hps-mershov/clock_design/clock_design.jpg

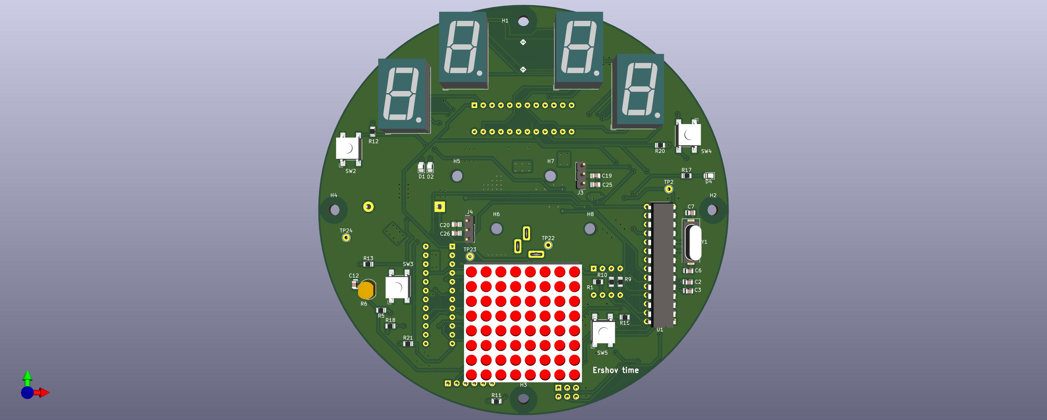
clock_design.jpg
