hps-mershov/clock_design/clock_design.kicad_pcb

## KiCad design clock_design.kicad_pcb (2022-07-19)

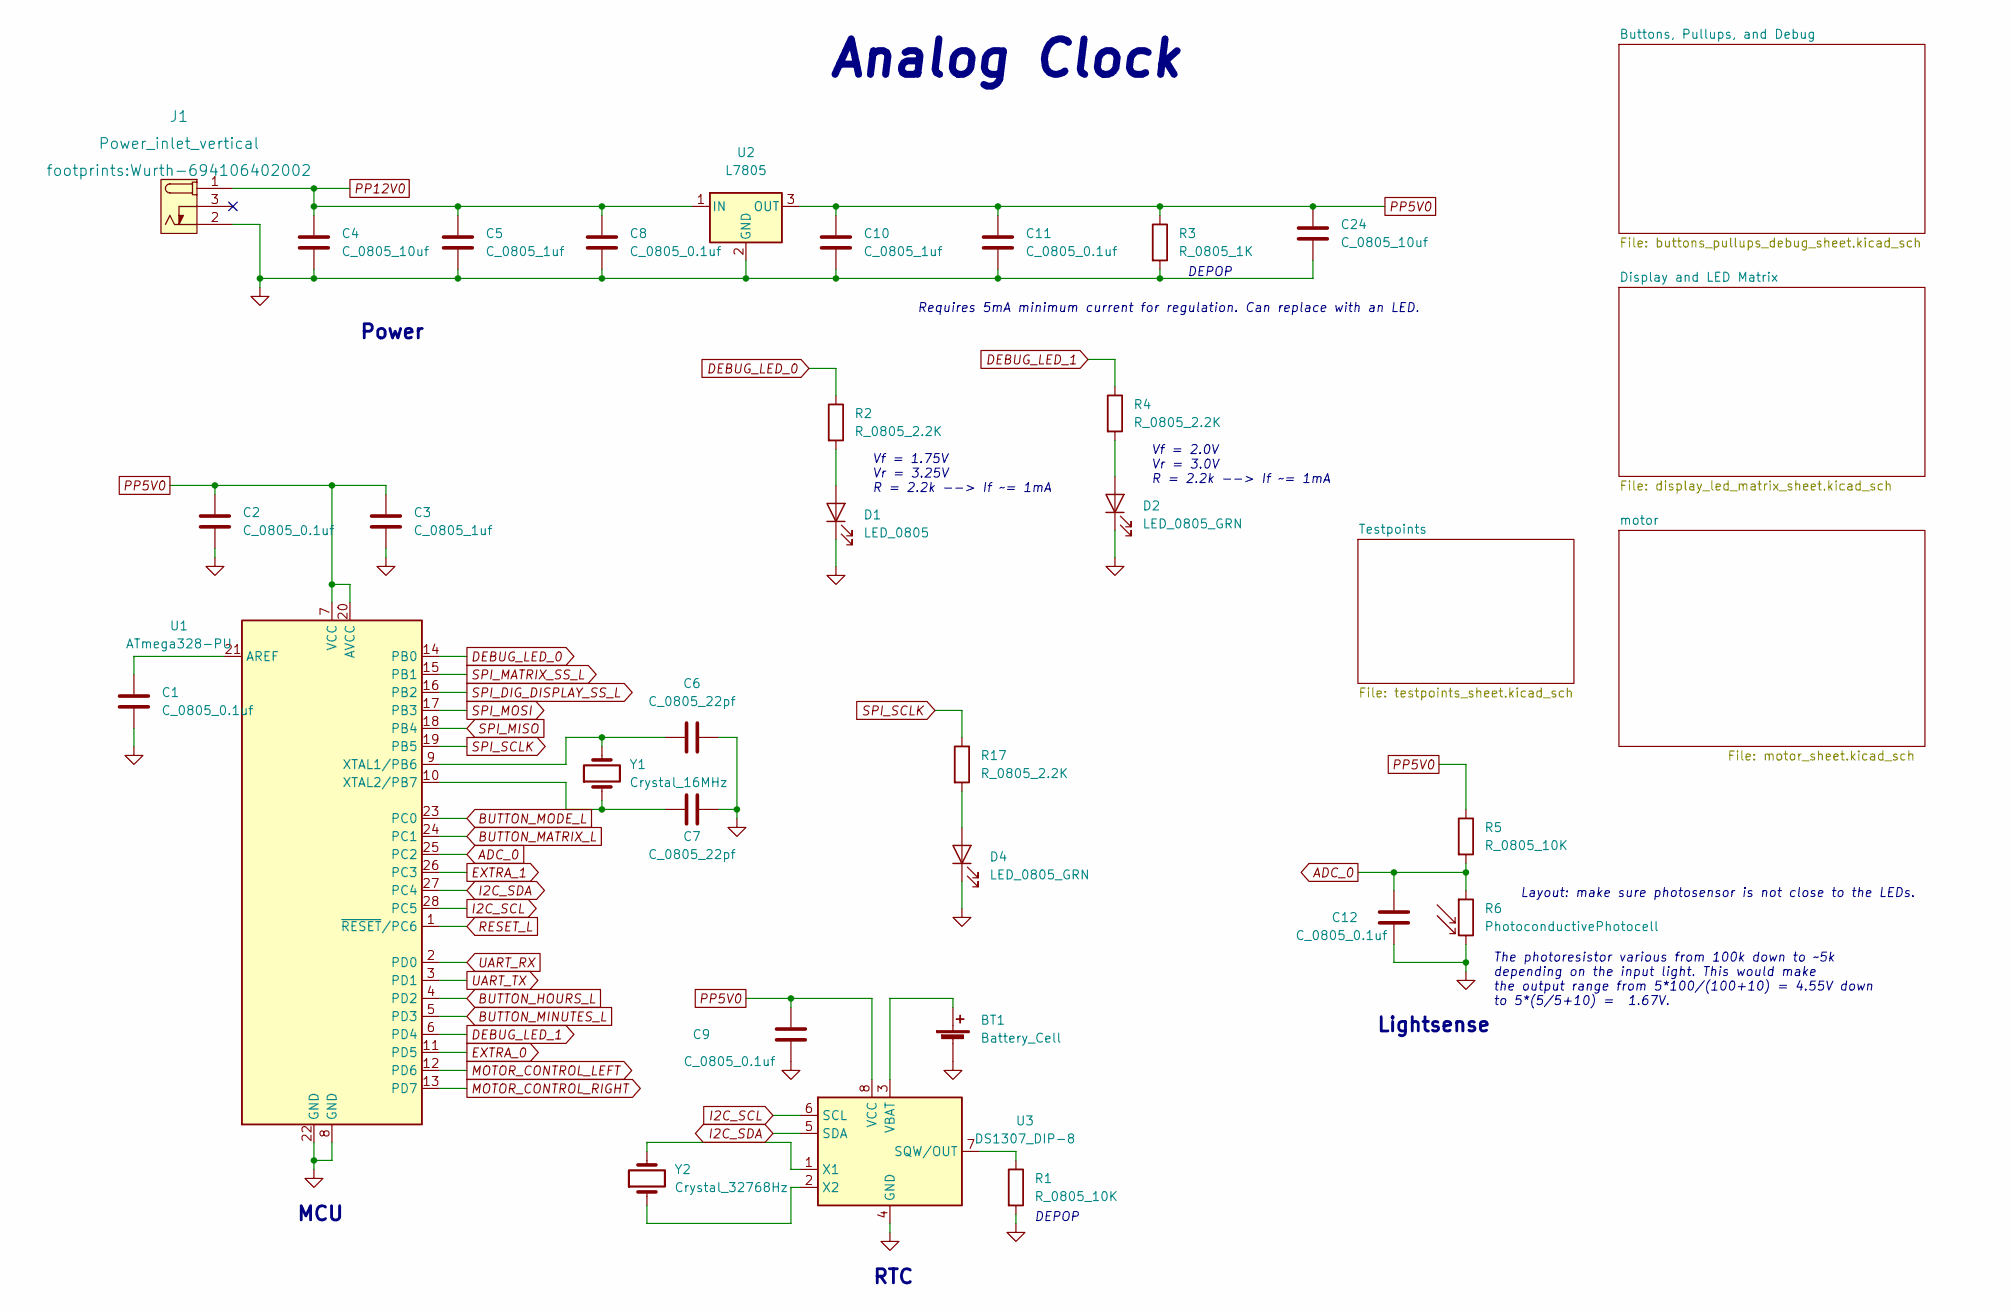
[picture p21: schematic clock_design.kicad_sch]

Parts:
BT1: Battery_Cell; BatteryHolder_Keystone_106_1x20mm; MPN BS-7; Digikey PN BS-7-ND
C1, C2, C8, C9, C11, C12: C_0805_0.1uf; C_0805_2012Metric; Voltage N/A; Tolerance N/A; MPN 08055C104KAT2A; Digikey PN 478-1395-1-ND
C3, C5, C10: C_0805_1uf; C_0805_2012Metric; Voltage N/A; Tolerance N/A; MPN CC0805KKX7R8BB105; Digikey PN 311-1456-1-ND
C4, C24: C_0805_10uf; C_0805_2012Metric; Voltage N/A; Tolerance N/A; MPN GRM21BR61E106KA73L; Digikey PN 490-5523-1-ND
C6, C7: C_0805_22pf; C_0805_2012Metric; Voltage N/A; Tolerance N/A; MPN CC0805JRNPO9BN220; Digikey PN 311-1103-1-ND
D1: LED_0805; LED_0805_2012Metric; MPN 150080RS75000; Digikey PN 732-4984-1-ND
D2, D4: LED_0805_GRN; LED_0805_2012Metric; MPN 150080VS75000; Digikey PN 732-4986-1-ND
J1: Power_inlet_vertical; Wurth-694106402002; MPN 694106402002; Digikey PN 732-5931-ND
R1, R5: R_0805_10K; R_0805_2012Metric; Tolerance N/A; MPN RC0805FR-0710KL; Digikey PN 311-10.0KCRCT-ND
R2, R4, R17: R_0805_2.2K; R_0805_2012Metric; Tolerance N/A; MPN N/A; Digikey PN 311-2.20KCRCT-ND
R3: R_0805_1K; R_0805_2012Metric; Tolerance N/A; Mouser PN N/A; Digikey PN RC0805FR-0710KL
R6: PhotoconductivePhotocell; R_LDR_4.9x4.2mm_P2.54mm_Vertical; Voltage N/A; Tolerance N/A; MPN PDV-P8103; Digikey PN PDV-P8103-ND
U1: ATmega328-PU; DIP-28_W7.62mm; MPN ED281DT; Digikey PN ED3050-5-ND
U2: L7805; TO-252-2
U3: DS1307_DIP-8; DIP-8_W7.62mm; MPN A 08-LC-TT; Digikey PN AE9986-ND
Y1: Crystal_16MHz; Crystal_SMD_HC49-SD; MPN ECS-160-20-5PXDN-TR; Digikey PN XC1299CT-ND
Y2: Crystal_32768Hz; Crystal_SMD_2Pin_3.2x1.5mm; MPN Q 0,032768-JTX310-12,5-20-T1-HMR-50K-LF; Digikey PN 1908-1314-1-ND

Connections:
ADC_0: C12.1, R5.2, R6.1, U1.25 (PC2)
BUTTON_HOURS_L: U1.4 (PD2); also elsewhere on the board
BUTTON_MATRIX_L: U1.24 (PC1); also elsewhere on the board
BUTTON_MINUTES_L: U1.5 (PD3); also elsewhere on the board
BUTTON_MODE_L: U1.23 (PC0); also elsewhere on the board
DEBUG_LED_0: R2.1, U1.14 (PB0); also elsewhere on the board
DEBUG_LED_1: R4.1, U1.6 (PD4)
EXTRA_0: U1.11 (PD5); also elsewhere on the board
EXTRA_1: U1.26 (PC3); also elsewhere on the board
GND: BT1.2 (-), C1.2, C2.2, C3.2, C4.2, C5.2, C6.2, C7.2, C8.2, C9.2, C10.2, C11.2, C12.2, C24.2, D1.1 (K), D2.1 (K), D4.1 (K), J1.2 (OUT), R1.2, R3.2, R6.2, U1.8 (GND), U1.22 (GND), U2.2 (GND), U3.4 (GND); also elsewhere on the board
I2C_SCL: U1.28 (PC5), U3.6 (SCL); also elsewhere on the board
I2C_SDA: U1.27 (PC4), U3.5 (SDA); also elsewhere on the board
MOTOR_CONTROL_LEFT: U1.12 (PD6); also elsewhere on the board
MOTOR_CONTROL_RIGHT: U1.13 (PD7); also elsewhere on the board
unnamed: BT1.1 (+), U3.3 (VBAT)
unnamed: C1.1, U1.21 (AREF)
unnamed: C6.1, U1.9 (XTAL1/PB6), Y1.2
unnamed: C7.1, U1.10 (XTAL2/PB7), Y1.1
unnamed: D1.2 (A), R2.2
unnamed: D2.2 (A), R4.2
unnamed: D4.2 (A), R17.2
unnamed: R1.1, U3.7 (SQW/OUT)
unnamed: U3.1 (X1), Y2.2
unnamed: U3.2 (X2), Y2.1
PP5V0: C2.1, C3.1, C9.1, C10.1, C11.1, C24.1, R3.1, R5.1, U1.7 (VCC), U1.20 (AVCC), U2.3 (OUT), U3.8 (VCC); also elsewhere on the board
PP12V0: C4.1, C5.1, C8.1, J1.1 (POLE), U2.1 (IN); also elsewhere on the board
RESET_L: U1.1 (~RESET/PC6); also elsewhere on the board
SPI_DIG_DISPLAY_SS_L: U1.16 (PB2); also elsewhere on the board
SPI_MATRIX_SS_L: U1.15 (PB1); also elsewhere on the board
SPI_MISO: U1.18 (PB4); also elsewhere on the board
SPI_MOSI: U1.17 (PB3); also elsewhere on the board
SPI_SCLK: R17.1, U1.19 (PB5); also elsewhere on the board
UART_RX: U1.2 (PD0); also elsewhere on the board
UART_TX: U1.3 (PD1); also elsewhere on the board

Notes on the sheet:
Vf = 1.75V Vr = 3.25V R = 2.2k --> If ~= 1mA
RTC
MCU
DEPOP
The photoresistor various from 100k down to ~5k depending on the input light. This would make the output range from 5*100/(100+10) = 4.55V down to 5*(5/5+10) = 1.67V.
Analog Clock
Power
Vf = 2.0V Vr = 3.0V R = 2.2k --> If ~= 1mA
Layout: make sure photosensor is not close to the LEDs.
Requires 5mA minimum current for regulation. Can replace with an LED.
Lightsense

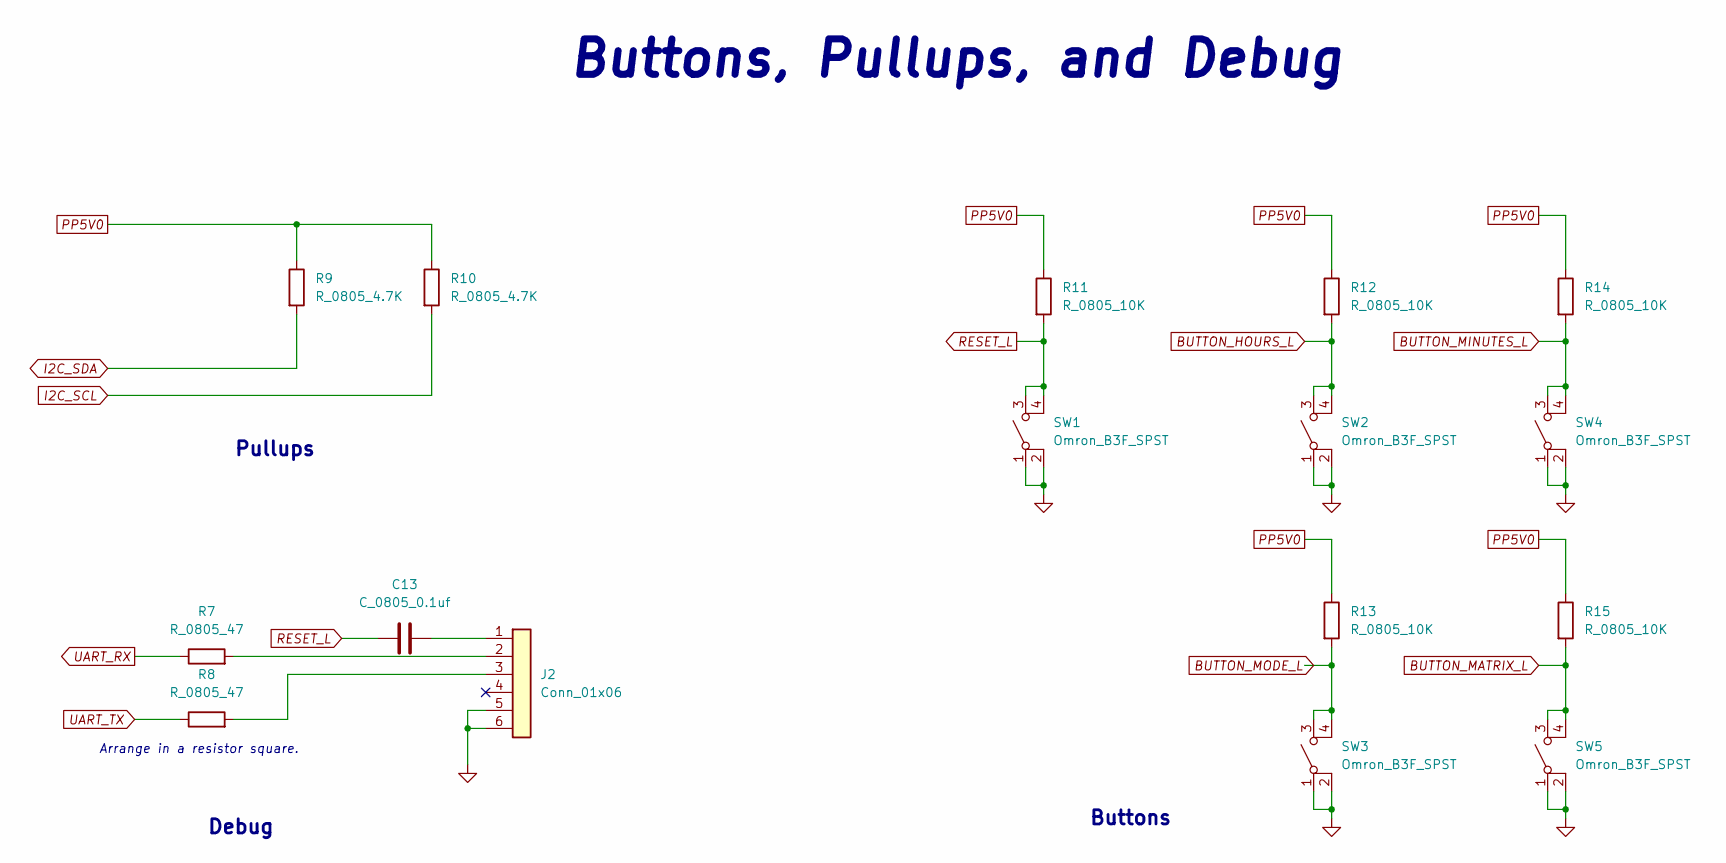
[picture p22: schematic buttons_pullups_debug_sheet.kicad_sch]

Parts:
C13: C_0805_0.1uf; C_0805_2012Metric; Voltage N/A; Tolerance N/A; MPN 08055C104KAT2A; Digikey PN 478-1395-1-ND
J2: Conn_01x06; PinHeader_1x06_P2.54mm_Vertical; MPN 61300611121; Digikey PN 732-5319-ND
R7, R8: R_0805_47; R_0805_2012Metric; Tolerance N/A; Mouser PN N/A; Digikey PN RC0805FR-0747RL
R9, R10: R_0805_4.7K; R_0805_2012Metric; Tolerance N/A; MPN RC0805FR-074K7L; Digikey PN 311-4.70KCRCT-ND
R11, R12, R13, R14, R15: R_0805_10K; R_0805_2012Metric; Tolerance N/A; MPN RC0805FR-0710KL; Digikey PN 311-10.0KCRCT-ND
SW1, SW2, SW3, SW4, SW5: Omron_B3F_SPST; SW_SPST_Omron_B3FS-100xP; MPN B3FS-1000P; Digikey PN SW423CT-ND

Connections:
BUTTON_HOURS_L: R12.2, SW2.3 (B), SW2.4 (B); also elsewhere on the board
BUTTON_MATRIX_L: R15.2, SW5.3 (B), SW5.4 (B); also elsewhere on the board
BUTTON_MINUTES_L: R14.2, SW4.3 (B), SW4.4 (B); also elsewhere on the board
BUTTON_MODE_L: R13.2, SW3.3 (B), SW3.4 (B); also elsewhere on the board
GND: J2.5, J2.6, SW1.1 (A), SW1.2 (A), SW2.1 (A), SW2.2 (A), SW3.1 (A), SW3.2 (A), SW4.1 (A), SW4.2 (A), SW5.1 (A), SW5.2 (A); also elsewhere on the board
I2C_SCL: R10.2; also elsewhere on the board
I2C_SDA: R9.2; also elsewhere on the board
unnamed: C13.2, J2.1
unnamed: J2.2, R7.2
unnamed: J2.3, R8.2
PP5V0: R9.1, R10.1, R11.1, R12.1, R13.1, R14.1, R15.1; also elsewhere on the board
RESET_L: C13.1, R11.2, SW1.3 (B), SW1.4 (B); also elsewhere on the board
UART_RX: R7.1; also elsewhere on the board
UART_TX: R8.1; also elsewhere on the board

Notes on the sheet:
Debug
Buttons, Pullups, and Debug
Pullups
Buttons
Arrange in a resistor square.

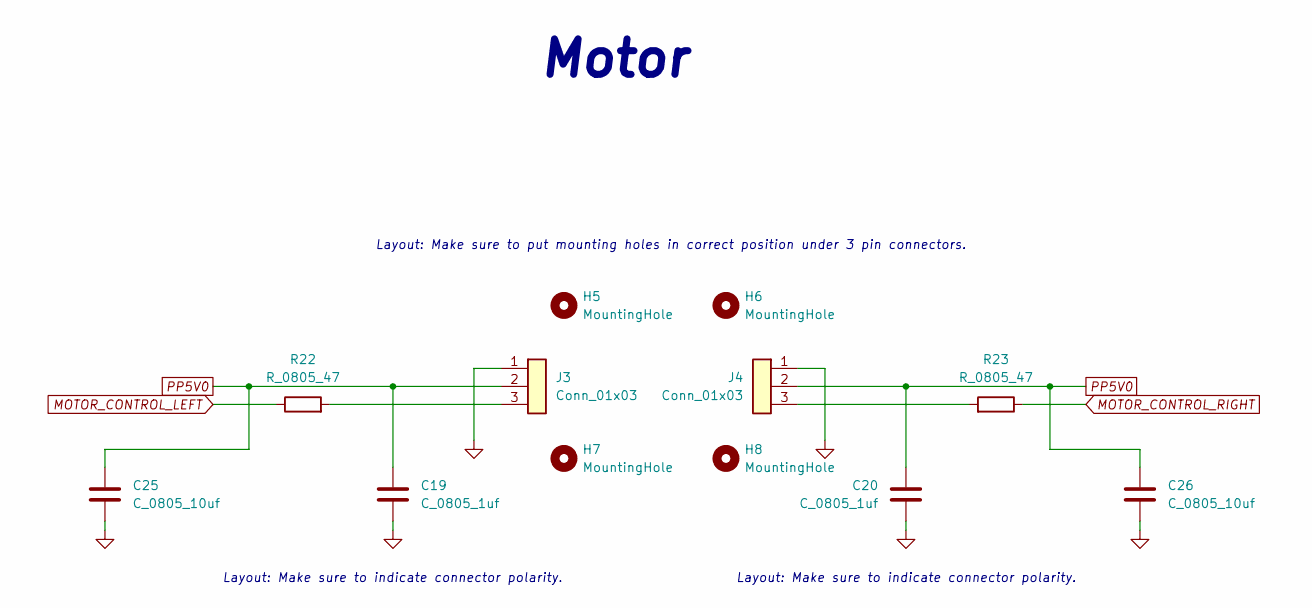
[picture p23: schematic motor_sheet.kicad_sch]

Parts:
C19, C20: C_0805_1uf; C_0805_2012Metric; Voltage N/A; Tolerance N/A; MPN CC0805KKX7R8BB105; Digikey PN 311-1456-1-ND
C25, C26: C_0805_10uf; C_0805_2012Metric; Voltage N/A; Tolerance N/A; MPN GRM21BR61E106KA73L; Digikey PN 490-5523-1-ND
H5, H6, H7, H8: MountingHole; MountingHole_3.2mm_M3
J3, J4: Conn_01x03; PinHeader_1x03_P2.54mm_Vertical; MPN 61300311121; Digikey PN 732-5316-ND
R22, R23: R_0805_47; R_0805_2012Metric; Tolerance N/A; Mouser PN N/A; Digikey PN RC0805FR-0747RL

Connections:
GND: C19.2, C20.2, C25.2, C26.2, J3.1, J4.1; also elsewhere on the board
MOTOR_CONTROL_LEFT: R22.1; also elsewhere on the board
MOTOR_CONTROL_RIGHT: R23.1; also elsewhere on the board
unnamed: J3.3, R22.2
unnamed: J4.3, R23.2
PP5V0: C19.1, C20.1, C25.1, C26.1, J3.2, J4.2; also elsewhere on the board

Notes on the sheet:
Motor
Layout: Make sure to indicate connector polarity.
Layout: Make sure to put mounting holes in correct position under 3 pin connectors.

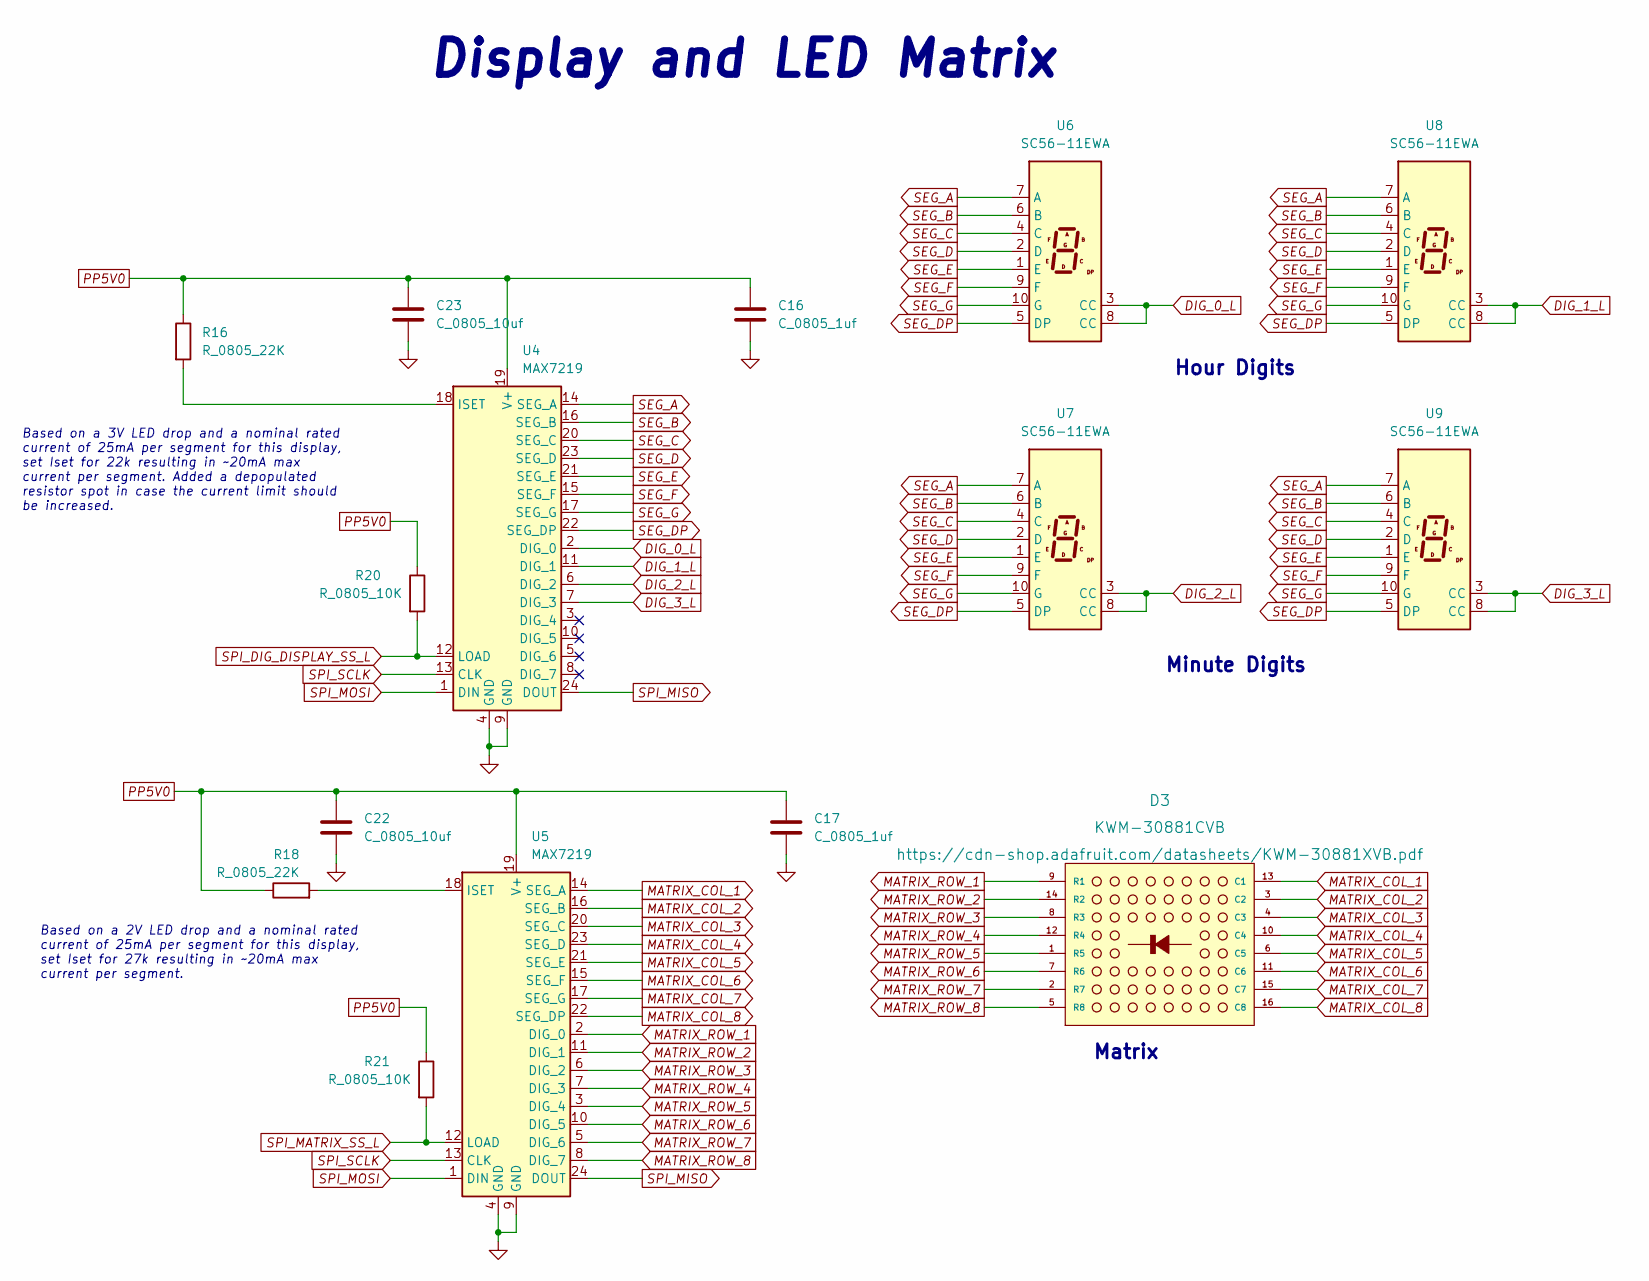
[picture p24: schematic display_led_matrix_sheet.kicad_sch]

Parts:
C16, C17: C_0805_1uf; C_0805_2012Metric; Voltage N/A; Tolerance N/A; MPN CC0805KKX7R8BB105; Digikey PN 311-1456-1-ND
C22, C23: C_0805_10uf; C_0805_2012Metric; Voltage N/A; Tolerance N/A; MPN GRM21BR61E106KA73L; Digikey PN 490-5523-1-ND
D3: KWM-30881CVB; MPN KWM-30881CVB; Digikey PN N/A
R16, R18: R_0805_22K; R_0805_2012Metric; Tolerance N/A; MPN RC0805FR-0722KL; Digikey PN 311-22.0KCRCT-ND
R20, R21: R_0805_10K; R_0805_2012Metric; Tolerance N/A; MPN RC0805FR-0710KL; Digikey PN 311-10.0KCRCT-ND
U4, U5: MAX7219; DIP-24_W7.62mm; MPN ED241DT; Digikey PN ED3049-5-ND
U6, U7, U8, U9: SC56-11EWA; Sx56-1xxxxx; Digikey PN 754-1465-5-ND

Connections:
DIG_0_L: U4.2 (DIG_0), U6.3 (CC), U6.8 (CC)
DIG_1_L: U4.11 (DIG_1), U8.3 (CC), U8.8 (CC)
DIG_2_L: U4.6 (DIG_2), U7.3 (CC), U7.8 (CC)
DIG_3_L: U4.7 (DIG_3), U9.3 (CC), U9.8 (CC)
GND: C16.2, C17.2, C22.2, C23.2, U4.4 (GND), U4.9 (GND), U5.4 (GND), U5.9 (GND); also elsewhere on the board
MATRIX_COL_1: D3.13 (C1), U5.14 (SEG_A)
MATRIX_COL_2: D3.3 (C2), U5.16 (SEG_B)
MATRIX_COL_3: D3.4 (C3), U5.20 (SEG_C)
MATRIX_COL_4: D3.10 (C4), U5.23 (SEG_D)
MATRIX_COL_5: D3.6 (C5), U5.21 (SEG_E)
MATRIX_COL_6: D3.11 (C6), U5.15 (SEG_F)
MATRIX_COL_7: D3.15 (C7), U5.17 (SEG_G)
MATRIX_COL_8: D3.16 (C8), U5.22 (SEG_DP)
MATRIX_ROW_1: D3.9 (R1), U5.2 (DIG_0)
MATRIX_ROW_2: D3.14 (R2), U5.11 (DIG_1)
MATRIX_ROW_3: D3.8 (R3), U5.6 (DIG_2)
MATRIX_ROW_4: D3.12 (R4), U5.7 (DIG_3)
MATRIX_ROW_5: D3.1 (R5), U5.3 (DIG_4)
MATRIX_ROW_6: D3.7 (R6), U5.10 (DIG_5)
MATRIX_ROW_7: D3.2 (R7), U5.5 (DIG_6)
MATRIX_ROW_8: D3.5 (R8), U5.8 (DIG_7)
unnamed: R16.2, U4.18 (ISET)
unnamed: R18.2, U5.18 (ISET)
PP5V0: C16.1, C17.1, C22.1, C23.1, R16.1, R18.1, R20.1, R21.1, U4.19 (V+), U5.19 (V+); also elsewhere on the board
SEG_A: U4.14 (SEG_A), U6.7 (A), U7.7 (A), U8.7 (A), U9.7 (A)
SEG_B: U4.16 (SEG_B), U6.6 (B), U7.6 (B), U8.6 (B), U9.6 (B)
SEG_C: U4.20 (SEG_C), U6.4 (C), U7.4 (C), U8.4 (C), U9.4 (C)
SEG_D: U4.23 (SEG_D), U6.2 (D), U7.2 (D), U8.2 (D), U9.2 (D)
SEG_DP: U4.22 (SEG_DP), U6.5 (DP), U7.5 (DP), U8.5 (DP), U9.5 (DP)
SEG_E: U4.21 (SEG_E), U6.1 (E), U7.1 (E), U8.1 (E), U9.1 (E)
SEG_F: U4.15 (SEG_F), U6.9 (F), U7.9 (F), U8.9 (F), U9.9 (F)
SEG_G: U4.17 (SEG_G), U6.10 (G), U7.10 (G), U8.10 (G), U9.10 (G)
SPI_DIG_DISPLAY_SS_L: R20.2, U4.12 (LOAD); also elsewhere on the board
SPI_MATRIX_SS_L: R21.2, U5.12 (LOAD); also elsewhere on the board
SPI_MISO: U4.24 (DOUT), U5.24 (DOUT); also elsewhere on the board
SPI_MOSI: U4.1 (DIN), U5.1 (DIN); also elsewhere on the board
SPI_SCLK: U4.13 (CLK), U5.13 (CLK); also elsewhere on the board

Notes on the sheet:
Hour Digits
Minute Digits
Based on a 3V LED drop and a nominal rated current of 25mA per segment for this display, set Iset for 22k resulting in ~20mA max current per segment. Added a depopulated resistor spot in case the current limit should be increased.
Matrix
Display and LED Matrix
Based on a 2V LED drop and a nominal rated current of 25mA per segment for this display, set Iset for 27k resulting in ~20mA max current per segment.

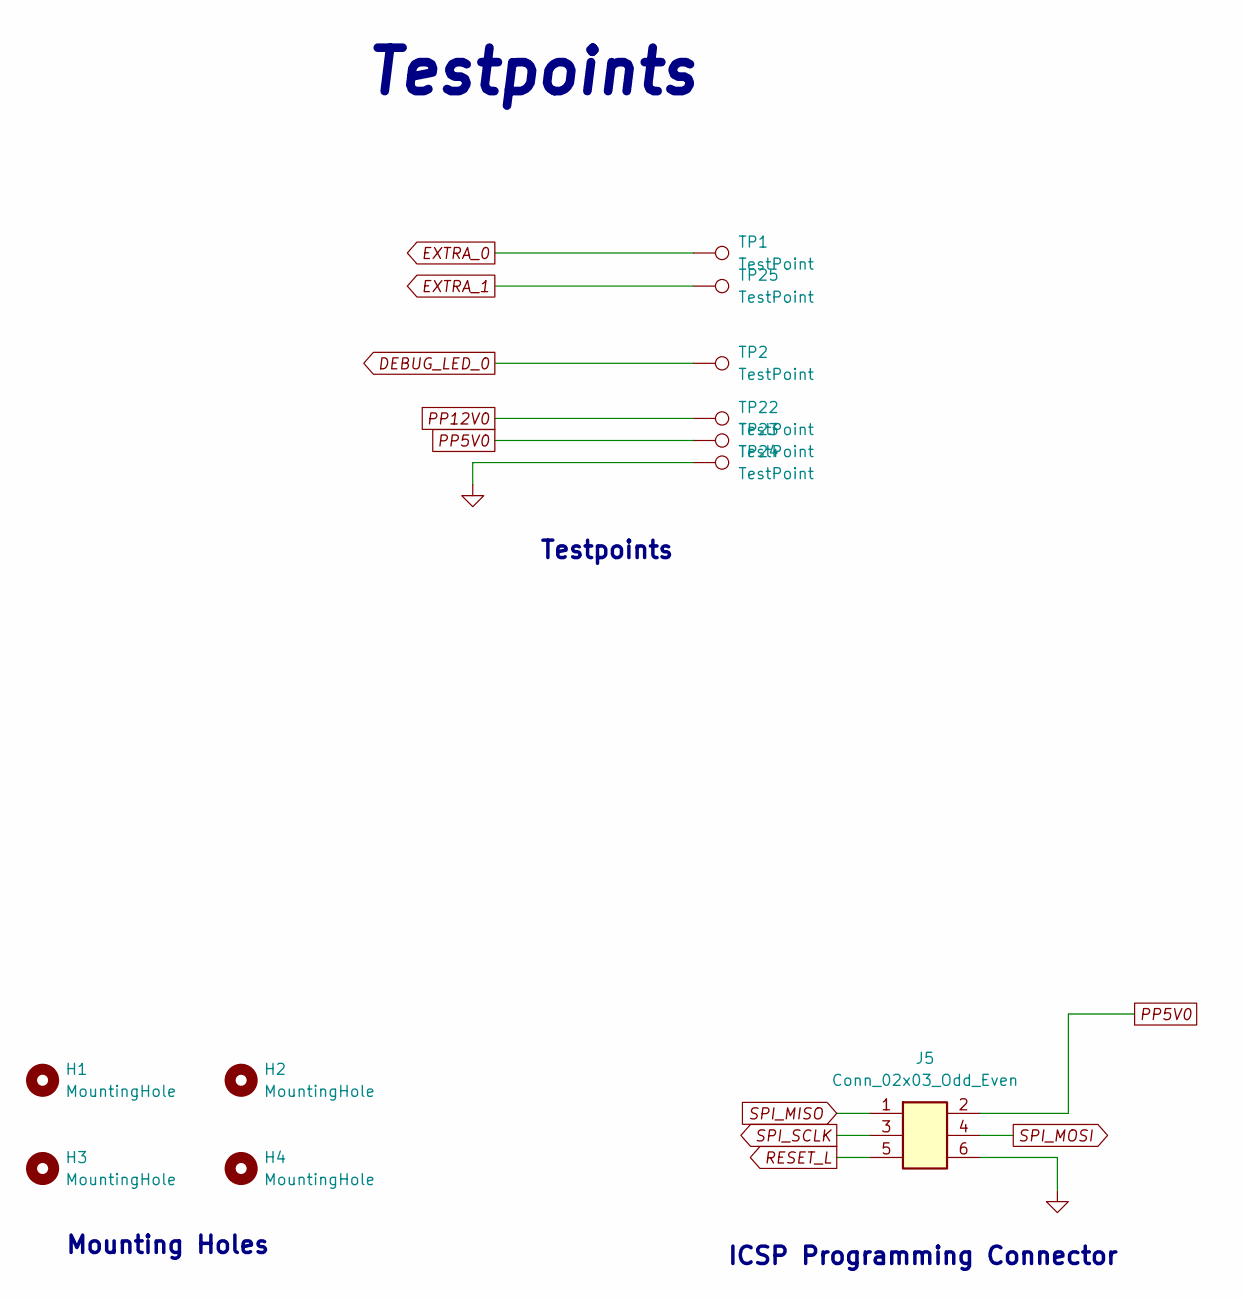
[picture p25: schematic testpoints_sheet.kicad_sch]

Parts:
H1, H2, H3, H4: MountingHole; MountingHole_3.2mm_M3
J5: Conn_02x03_Odd_Even; PinHeader_2x03_P2.54mm_Vertical; MPN PRPC003DAAN-RC; Digikey PN S2011EC-03-ND
TP1, TP2, TP22, TP23, TP24, TP25: TestPoint; TestPoint_THTPad_D2.0mm_Drill1.0mm

Connections:
DEBUG_LED_0: TP2.1; also elsewhere on the board
EXTRA_0: TP1.1; also elsewhere on the board
EXTRA_1: TP25.1; also elsewhere on the board
GND: J5.6, TP24.1; also elsewhere on the board
PP5V0: J5.2, TP23.1; also elsewhere on the board
PP12V0: TP22.1; also elsewhere on the board
RESET_L: J5.5; also elsewhere on the board
SPI_MISO: J5.1; also elsewhere on the board
SPI_MOSI: J5.4; also elsewhere on the board
SPI_SCLK: J5.3; also elsewhere on the board

Notes on the sheet:
Mounting Holes
ICSP Programming Connector
Testpoints

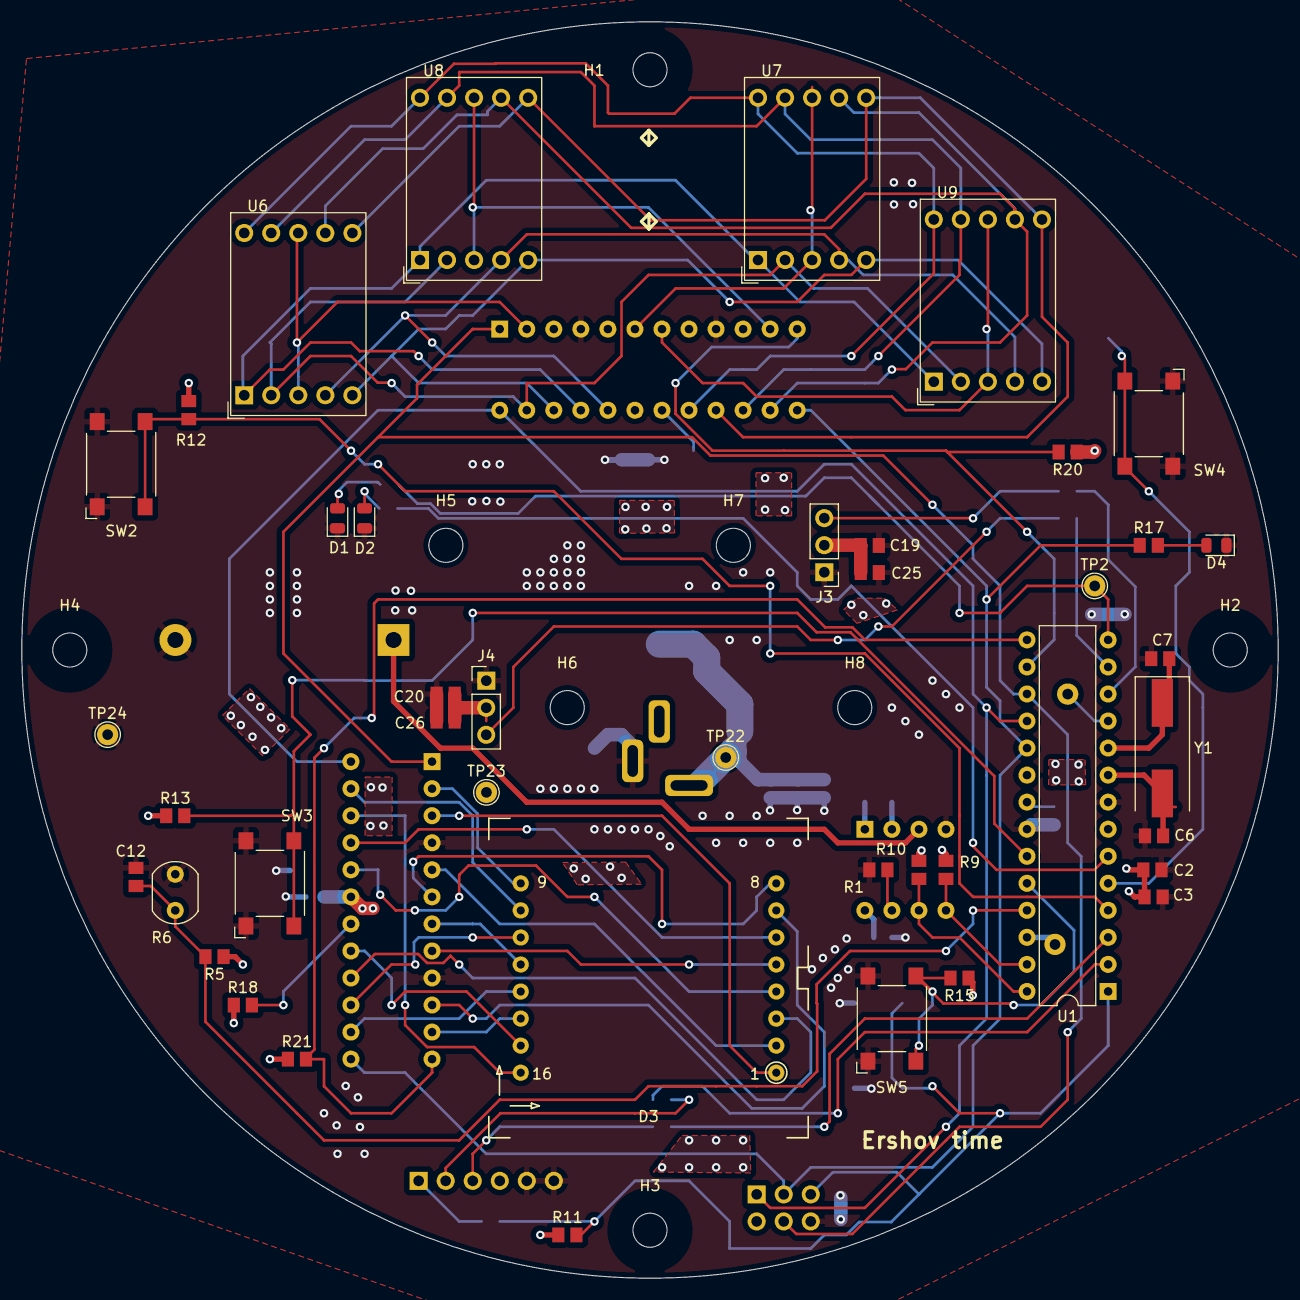
[picture p26: board clock_design.kicad_pcb from above]

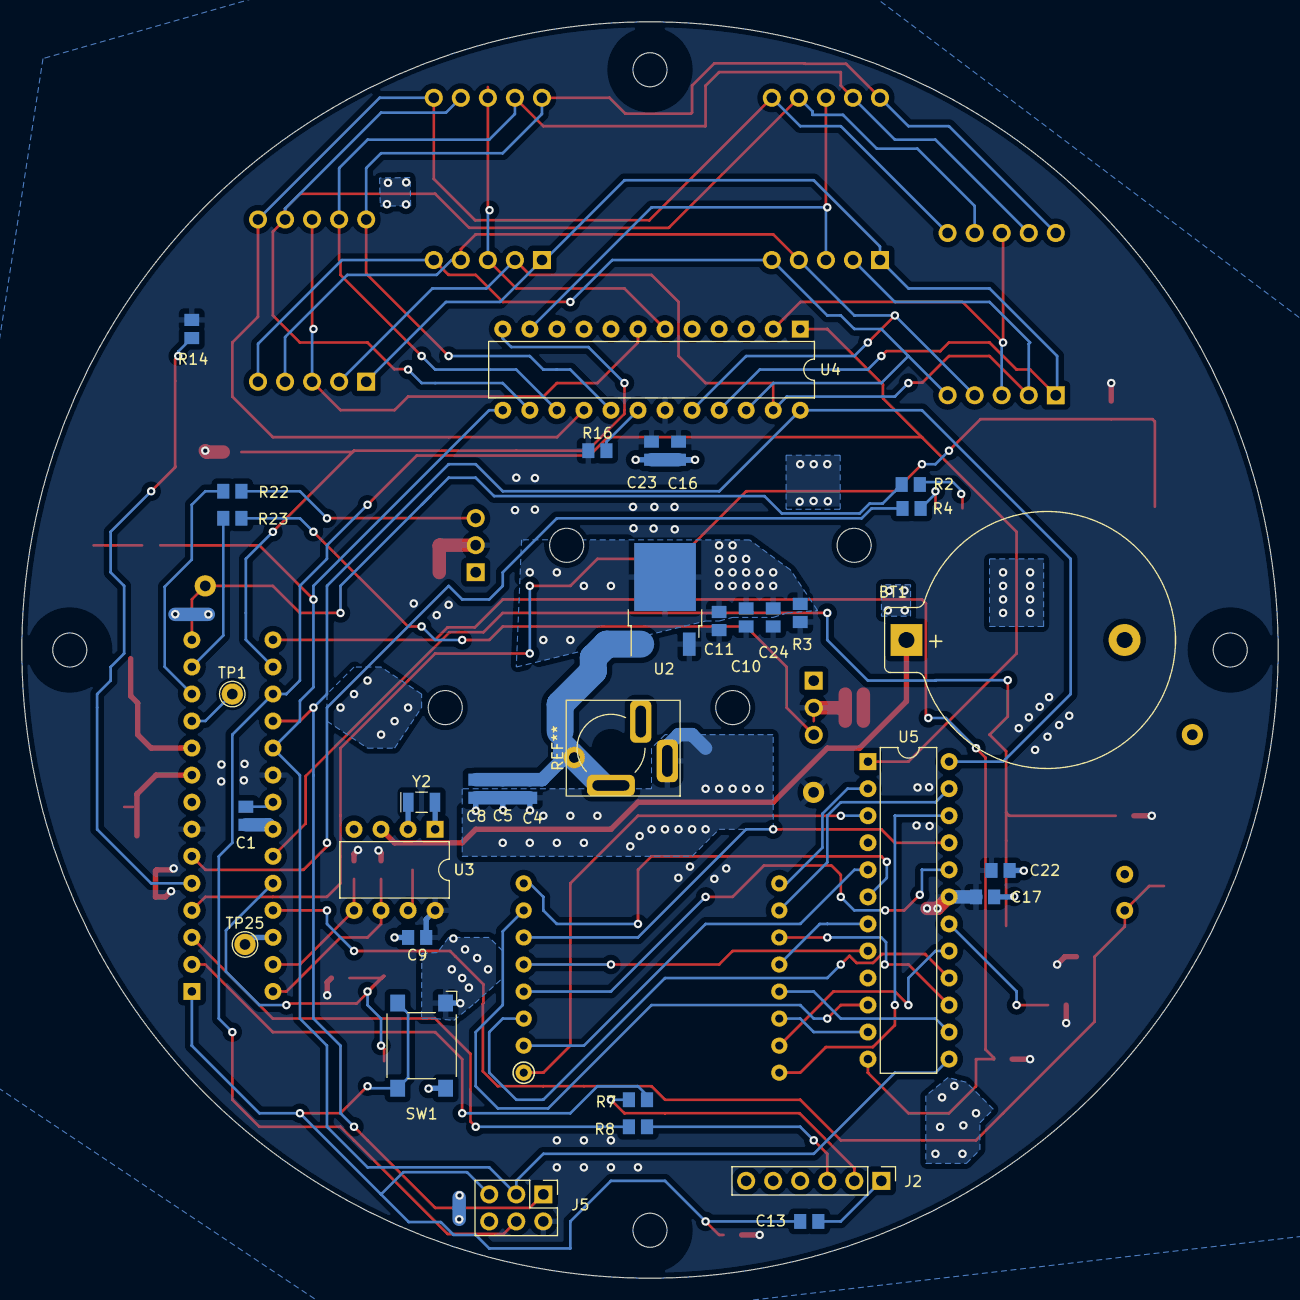
[picture p27: board clock_design.kicad_pcb from below]

Board: 2 copper layers, 118.0 x 118.0 mm, 84 parts (34 on the bottom side), 69 nets.
