hps-mershov/clock_design/(commit log)

2022-07-15 Added new BOM (a single LED + resistor).
    [clock_design.csv, clock_design.kicad_sch]
2022-07-15 Routing in progress...
    [clock_design.kicad_pcb, clock_design.kicad_sch]
2022-07-19 Initial gerber out
    Got all of the files for gereber out
    [clock_design-B_Cu.gbr, clock_design-B_Mask.gbr, clock_design-B_Paste.gbr, clock_design-B_Silkscreen.gbr, clock_design-Edge_Cuts.gbr, clock_design-F_Cu.gbr, clock_design-F_Mask.gbr, clock_design-F_Paste.gbr]
2022-07-19 gerber zip added for DFM
2022-07-21 final gerber (no chang)
